JamesClarke01/EasyScope/ArduinoMount/README.md

# GoToArduino
Arduino Code for GoTo Mount
