JamesClarke01/EasyScope/ArduinoMount/Mount-Main/Mount-Main.ino

#include <Servo.h>

#include <Stepper.h>
#include <AFMotor.h>
#include <SoftwareSerial.h>
#include <ArduinoJson.h>

//Stepper
#define STEPS_PER_REV 4096
#define STEPPER_PORT 2
#define STEPPER_SPEED 20 //rpm
#define MANUAL_STEPS 5

//Servo
#define SERVO_LEFT_PIN 10
#define SERVO_RIGHT_PIN 9
#define SERVO_STEP 1

//HC-05
#define BT_RX 2
#define BT_TX_UNUSED 0

//Bounds
#define ALT_LOW_BOUND 12
#define ALT_HIGH_BOUND 84

//Enums
enum ReceiveMode {MANUAL, JSON};
enum CoordType {ALT, AZ};

//Hardware components delcarations
AF_Stepper stepper(STEPS_PER_REV/2, STEPPER_PORT) ; 
Servo leftServo, rightServo;
SoftwareSerial BTSerial(BT_RX, BT_TX_UNUSED); 

class DirectionClass {
  private:
    int alt;
    int az;

  public:

    DirectionClass() {
      //Initialise values
      alt = ALT_LOW_BOUND;
      az = 0;

      //Move to initial positions
      moveToAlt(ALT_LOW_BOUND);
      moveToAz(0);
    }

    void moveLeftServo(int pAlt) {
      //for C577 servo
      //left range: 90 -> 0
      leftServo.write(map(pAlt, 0, 90, 90, 0));
    }

    void moveRightServo(int pAlt) {
      //for C577 servo
      //right range: 90 -> 180
      rightServo.write(map(pAlt, 0, 90, 90, 180));
    }

    //Steppers
    void moveToAlt(int pAlt) {
      int leftAngle, rightAngle;
      const int increment = 10;

      if (pAlt >= ALT_LOW_BOUND && pAlt <= ALT_HIGH_BOUND) {                    
        
        //Move each servo in steps to keep the two in sync
        if (pAlt > alt) {
                    
          for(int i = increment; (alt + i) <= pAlt; i += increment) {                         
            moveLeftServo(alt+i);
            moveRightServo(alt+i);
            delay(100);
          }
        } else if (pAlt < alt) {          
          for(int i = increment; alt - i >= pAlt; i += increment) {
            moveLeftServo(alt-i);
            moveRightServo(alt-i);
            delay(100);
          } 
        }

        //Move the remainder
        moveLeftServo(pAlt);
        moveRightServo(pAlt);
        
        alt = pAlt; //update current alt
      }
    }

    void manualAltIncrease(void) {
      moveToAlt(alt+SERVO_STEP);
    }

    void manualAltDecrease(void) {
      moveToAlt(alt-SERVO_STEP);
    }

    //Servos
    void moveToAz(int pAz) {
      int direction;
      int degToMove = pAz-az;
      int stepsToMove;

      if (degToMove < 0) {
        direction = BACKWARD;
      } else {
        direction = FORWARD;
      }

      stepsToMove = map(abs(degToMove), 0, 360, 0, STEPS_PER_REV);

      stepper.step(stepsToMove, direction, INTERLEAVE);
      //Serial.println(degToMove);

      az = pAz;
    }

    manualAzIncrease(void) {
      az += MANUAL_STEPS;
      stepper.step(MANUAL_STEPS, FORWARD, INTERLEAVE);  
    }

    manualAzDecrease(void) {
      az -= MANUAL_STEPS;
      stepper.step(MANUAL_STEPS, BACKWARD, INTERLEAVE);  
    }

    void setAz(double pAz) {
      az = pAz;
      Serial.print("New Azimuth Value: ");
      Serial.print(az);
      Serial.print("\n");
    }
};

//Global Vars
DirectionClass direction;
String altStr;
String azStr;
enum ReceiveMode receiveMode;
enum CoordType coordType;

//JSON
String jsonString;
int curlyCount = 0;

//Function Headers
int handleSingleByte(char input);
int handleCoordChar(char input);

void setup()
{
  //Serial Setup
  Serial.begin(115200);

  //BT Setup
  BTSerial.begin(38400);

  //Stepper Setup
  stepper.setSpeed(STEPPER_SPEED);

  //Servo Setup  
  leftServo.attach(SERVO_LEFT_PIN);
  rightServo.attach(SERVO_RIGHT_PIN);
  
  //Flags
  receiveMode = MANUAL;
  coordType = ALT;
}
 
void loop()
{  
  if(BTSerial.available()) {
    char rChar = BTSerial.read();
    Serial.println(rChar);

    switch (receiveMode) {      
      case MANUAL:
        handleSingleByte(rChar);
        break;
      case JSON:
        handleJsonByte(rChar);
        break;      
    }    
  }
  return 0;
}

int handleJsonByte(char rChar) {
  //Receiving JSON String
  
  jsonString += rChar;
  
  if (rChar == '{') {
    curlyCount++;
  } else if (rChar == '}') {
    curlyCount--;
    if (curlyCount == 0) {  //reached end of json
      receiveMode = MANUAL;
      processJSON(jsonString);
    }
  }
}

int handleSingleByte(char rChar) {
  switch (rChar) {
    case 'r':  //Move Right
      direction.manualAzIncrease();
      break;
    case 'l':  //Move Left
      direction.manualAzDecrease();
      break;              
    case 'u':  //Move Up
      direction.manualAltIncrease();
      break;
    case 'd':  //Move Down
      direction.manualAltDecrease();
      break;    
    case '{':  //Enter json Mode
      Serial.println("Entering JSON mode...");
      curlyCount = 1;
      jsonString = "{";
      receiveMode = JSON;
      break;
  }
}

void processJSON(String pJson) {
 
  Serial.println("Processing JSON...");
  StaticJsonDocument<100> doc;
  char* jsonArray = new char[pJson.length()+1];  //allocate a new json array on the heap
  
  strcpy(jsonArray, pJson.c_str());  //Copy json string into json array

  DeserializationError error = deserializeJson(doc, jsonArray);  //deserialize json

  // Test if parsing succeeds.
  if (error) {
    Serial.print(F("deserializeJson() failed: "));
    Serial.println(error.f_str());
    return;
  }

  const char* instruction = doc["Instruction"];

  if(strcmp(instruction, "Slew") == 0) {                 
    slew(doc["Data"]["Altitude"], doc["Data"]["Azimuth"]);
  } else if(strcmp(instruction, "Calibrate") == 0) {
    calibrate(doc["Data"]["Azimuth"]);
  } else if(strcmp(instruction, "Reset") == 0) {
    reset();
  }

  delete[] jsonArray;  //Deallocate json array (important!)
}

void slew(double alt, double az) {
  Serial.println("Slewing");     
  direction.moveToAlt(alt);
  direction.moveToAz(az);
}

void calibrate(double pAz) {
  direction.setAz(pAz);
}

void reset() {
  direction.moveToAlt(ALT_LOW_BOUND);
}
