JamesClarke01/EasyScope/(commit log)

2023-11-03 NSEW with stepper
2023-11-03 Stepper motor code
2023-11-13 Control buttons streaming serial data (horrendous code)
2024-01-18 Bluetooth & Calibration Activities Added
2024-01-23 Dual Servos
2024-01-29 Added a test for the stepper using accelStepper. Stepper now working reliably
2024-02-09 Arduino code folder restructure
2024-02-09 Arduino Code Restructuring
2024-02-19 Controlling main mount with Ada Shield
2024-02-19 JSON move-to-coords on prototype
2024-02-19 JSON too slow for manual movement
    [Mount-Prototype.ino]
2024-02-20 Moon button
2024-02-24 Added toMain button on calibration screen and started sendCalibrateData function
2024-02-25 Created a 'Calibrate' JSON instruction to send the phone's azimuth value to the mount and have the mount set that as it's azimuth. Added a 'Reset' JSON instruction which sets the mounts alt, to make 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
    [Mount-Main.ino]
2024-03-14 Debug Buttons Removed
2024-03-20 Fixed bug where it would not send reset signal when calibration activity created (bind function was asynchronous)
2024-03-20 Now getting location data on calibration
2024-03-21 Can't go to main until calibrated once.
2024-03-21 Added button that cancels current slew.
2024-03-25 Planet selection is now carried out through a list and not from buttons.
2024-03-28 Stars & Planets that are currently under the horizon are greyed out when listed, and cannot be selected.
2024-04-04 Switched Manual Buttons to images.
2024-04-12 Custom Piece Schematics
